afbento/Hotbit-RGB-Adapter/README.md

# Hotbit-RGB-Adapter
A simple [and cheap] Y(R-Y)(B-Y) to RGB for the Hotbit HB-8000 MSX1 computer.

Based on the circuit at : http://www.msxarchive.nl/pub/msx/mirrors/hanso/hwdoityourself/rgbmsx1.pdf

Tested with VGA Monitor Samsung Syncmaster 510n (firmware 97D2). 

I don´t know if it works on others 15kHz monitor models.

Project made on Proteus 8.9.
