afbento/Hotbit-RGB-Adapter/sch_v03_2023.pdf

Q10
U1

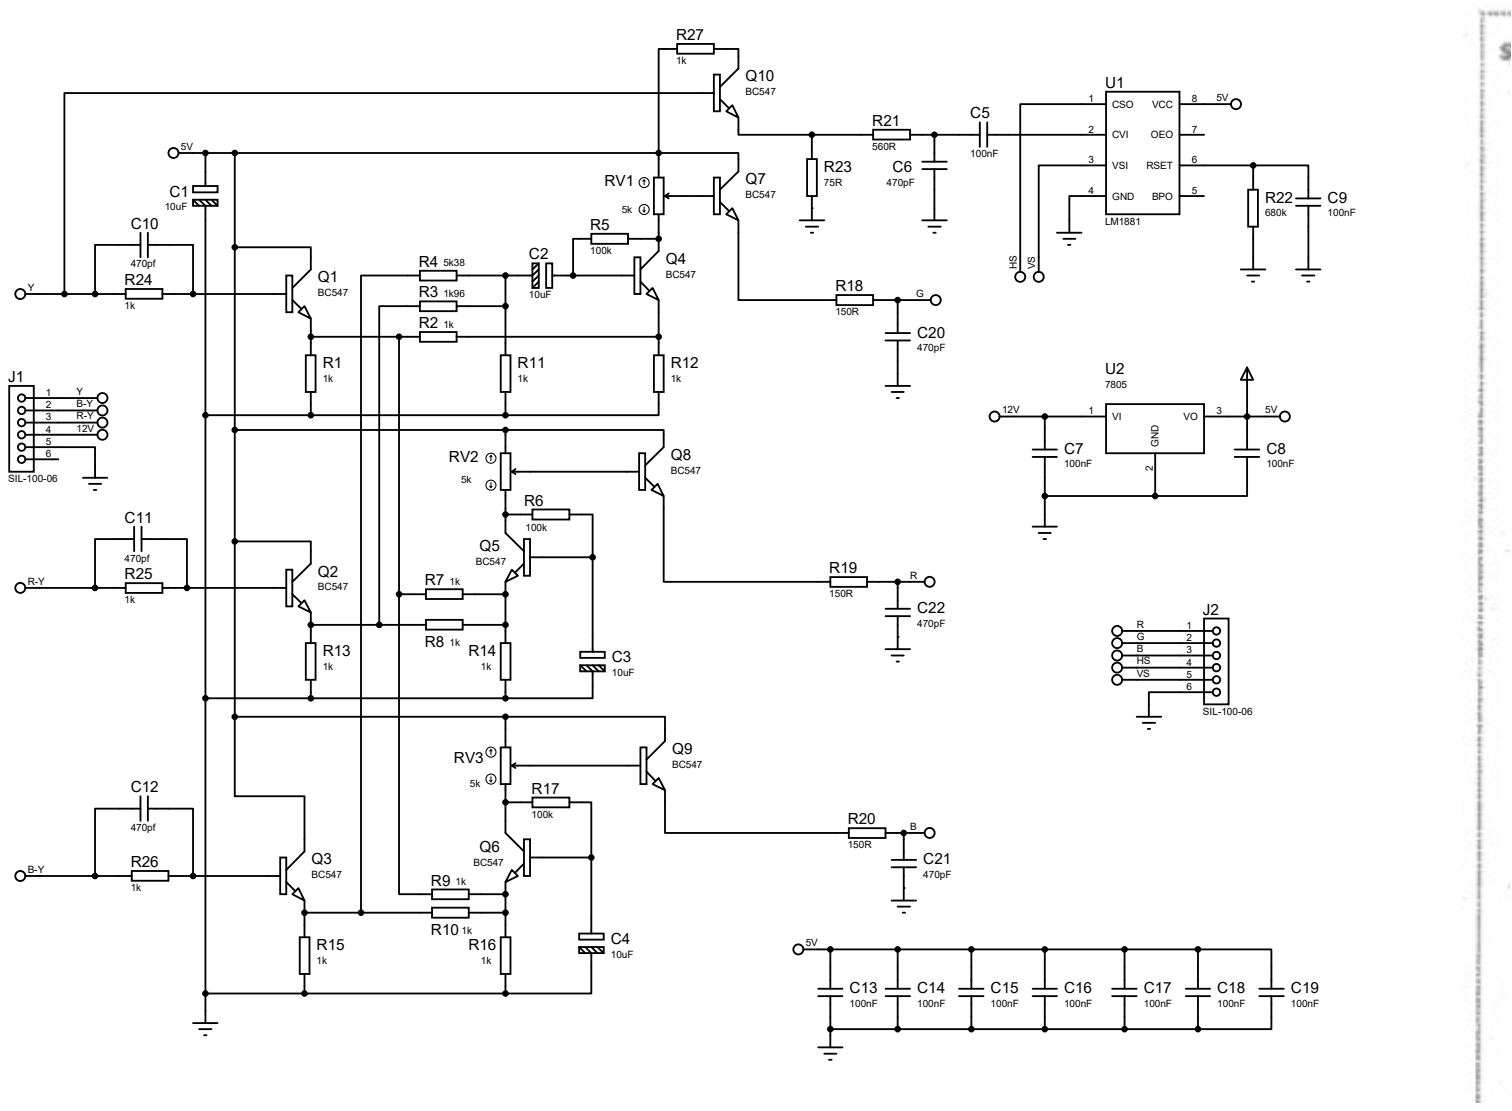
[picture p4: page 1]
