afbento/Hotbit-RGB-Adapter/(list of files, drawings)

Other design files:
rgbmsx_v_03_2023.pdsprj
